duyhoangbk23/CO3091_DA_TKLL_252/Report/sections/05-firmware-doc-du-lieu.tex

\section{Firmware đọc dữ liệu và xử lý cục bộ}

\subsection{Vai trò của firmware}

Firmware chính của hệ thống nằm trong nhánh \texttt{rtos} và chạy trên ESP32 bằng
PlatformIO/Arduino framework kết hợp FreeRTOS. Vai trò của firmware là thu thập dữ liệu
từ các cảm biến, chuẩn hóa thành mẫu đo thống nhất, đánh giá trạng thái chất lượng không
khí và điều khiển cảnh báo cục bộ trước khi dữ liệu được gửi lên backend. Các sketch
kiểm thử phần cứng chỉ phục vụ giai đoạn thử nghiệm từng cảm biến riêng lẻ, không phải
luồng vận hành chính của hệ thống.

Xét theo chức năng, firmware có thể được chia thành ba lớp. Lớp thứ nhất là các driver
giao tiếp với PMS7003, RS485 Modbus và ADC. Lớp thứ hai là \texttt{SensorHub}, có nhiệm
vụ gom dữ liệu từ nhiều nguồn thành một mẫu đo thống nhất. Lớp thứ ba là khối IAQ, gồm
\texttt{IaqEvaluator} và \texttt{IaqController}, chịu trách nhiệm đánh giá trạng thái môi
trường và chuyển kết quả thành trạng thái điều khiển thiết bị mô phỏng, cảnh báo.

\begin{center}
\texttt{Sensor drivers -> SensorHub -> SensorSample -> IaqEvaluator -> IaqController/MQTT}
\end{center}

\subsection{Mô hình dữ liệu trung tâm}

Đơn vị dữ liệu trung tâm của firmware là \texttt{SensorSample}. Cấu trúc này giữ các giá
trị đo dưới dạng phù hợp cho xử lý nhúng, trong đó nhiệt độ, độ ẩm và một số đại lượng
nội bộ được biểu diễn theo fixed-point nhân hệ số 10 để giảm phụ thuộc vào tính toán số
thực ở tầng đọc cảm biến. Đồng thời, mỗi nhóm dữ liệu đều có cờ hợp lệ hoặc giá trị
sentinel đi kèm để phân biệt giữa dữ liệu hợp lệ và dữ liệu thiếu.

\begin{table}[H]
    \centering
    \caption{Các nhóm trường chính của \texttt{SensorSample}}
    \begin{tabularx}{\textwidth}{>{\bfseries}l X}
        \toprule
        Nhóm trường & Vai trò trong firmware \\
        \midrule
        Thời gian đo & Lưu mốc thời gian tương đối tại thời điểm đọc mẫu \\
        PM1.0/PM2.5/PM10 & Giữ dữ liệu bụi mịn từ PMS7003; dùng PM2.5 làm chỉ số chính trong luồng dữ liệu IoT \\
        Nhiệt độ, độ ẩm & Lưu giá trị từ cảm biến RS485 dưới dạng fixed-point x10 \\
        CO\textsubscript{2} & Lưu nồng độ CO\textsubscript{2} theo ppm \\
        VOC & Lưu giá trị VOC raw và giá trị trung bình trượt dùng cho đánh giá \\
        Cờ hợp lệ & Cho biết từng nhóm cảm biến có đọc thành công hay không \\
        \bottomrule
    \end{tabularx}
\end{table}

Cách tổ chức này cho phép tầng đánh giá IAQ làm việc trên một cấu trúc dữ liệu đồng
nhất, thay vì phải phụ thuộc vào chi tiết giao thức của từng cảm biến. Đây cũng là cơ sở
để ánh xạ dữ liệu sang \texttt{SensorData\_t} và telemetry JSON ở các bước sau.

\subsection{Đọc cảm biến và chuẩn hóa dữ liệu}

\texttt{SensorHub} là điểm gom dữ liệu từ ba nhóm giao tiếp phần cứng. Khi được khởi tạo,
thành phần này cấu hình UART1 cho PMS7003, UART2 cho RS485 Modbus và ADC1 cho cảm biến
VOC. Trong quá trình đọc mẫu, từng cảm biến được truy xuất với timeout riêng; nếu một
cảm biến lỗi, mẫu đo vẫn được trả về nhưng nhóm dữ liệu tương ứng được đánh dấu không
hợp lệ.

\begin{table}[H]
    \centering
    \caption{Các driver cảm biến và cách xử lý dữ liệu}
    \begin{tabularx}{\textwidth}{>{\bfseries}l l X}
        \toprule
        Cảm biến & Giao tiếp & Cách xử lý chính \\
        \midrule
        PMS7003 & UART1 9600 bps & Tìm header \texttt{0x42 0x4D}, đọc đủ frame, kiểm tra checksum và tách PM1.0/PM2.5/PM10 \\
        CO\textsubscript{2} RS485 & Modbus RTU & Gửi request function \texttt{0x03}, đọc register \texttt{0x0001}, kiểm tra độ dài response, slave ID, function code và CRC16 \\
        Nhiệt độ/độ ẩm RS485 & Modbus RTU & Gửi request function \texttt{0x03}, đọc hai register từ \texttt{0x0000}, chuyển dữ liệu về dạng fixed-point x10 \\
        VOC analog & ADC1 GPIO34 & Đọc ADC 12-bit, cấu hình attenuation và dùng trung bình trượt để giảm nhiễu tức thời \\
        \bottomrule
    \end{tabularx}
\end{table}

Hai nguyên tắc quan trọng của tầng driver là timeout và kiểm tra giao thức. PMS7003 chỉ
được xem là hợp lệ khi checksum đúng. Với Modbus, response chỉ được chấp nhận khi khớp
slave ID, function code, byte count và CRC16. Nhờ đó, lỗi dây nối, cảm biến chưa cấp
nguồn hoặc nhiễu đường truyền không dẫn đến việc firmware dùng nhầm giá trị rác cho tầng
đánh giá.

\subsection{Đánh giá IAQ và cơ chế hysteresis}

\texttt{IaqEvaluator} là thành phần chuyển \texttt{SensorSample} thành \texttt{IaqState}.
Mỗi đại lượng được so sánh với một cặp ngưỡng bật/tắt để quyết định có cần kích hoạt
thiết bị xử lý hay không. Cơ chế này được triển khai theo hướng hysteresis, nghĩa là hệ
thống không dùng một ngưỡng duy nhất cho cả quá trình bật và tắt thiết bị. Thay vào đó,
thiết bị chỉ được bật khi giá trị đo vượt ngưỡng trên và chỉ tắt khi giá trị quay trở
lại dưới ngưỡng hồi phục.

\begin{table}[H]
    \centering
    \caption{Các ngưỡng điều khiển mặc định trong firmware}
    \begin{tabularx}{\textwidth}{>{\bfseries}l l X}
        \toprule
        Đại lượng & Cặp ngưỡng mặc định & Ý nghĩa vận hành \\
        \midrule
        CO\textsubscript{2} & \texttt{1000/950} ppm & Bật xử lý khi CO\textsubscript{2} cao và chỉ tắt khi đã giảm xuống dưới ngưỡng hồi phục \\
        PM2.5 & \texttt{35/30} \(\mu g/m^3\) & Điều khiển lọc bụi theo mức bụi mịn \\
        VOC & \texttt{500/450} & Điều khiển thông gió và lọc than theo VOC raw/index \\
        Nhiệt độ & \texttt{30.0/28.0} \(^{\circ}C\) & Điều khiển thiết bị làm mát mô phỏng \\
        Độ ẩm thấp & \texttt{30.0/35.0}\%RH & Bật/tắt tạo ẩm \\
        Độ ẩm cao & \texttt{65.0/60.0}\%RH & Bật/tắt thông gió khi quá ẩm \\
        \bottomrule
    \end{tabularx}
\end{table}

Ngoài hysteresis, firmware còn áp dụng thời gian giữ trạng thái mặc định 5000 ms cho các đầu ra xử lý.
Khi trạng thái vừa đổi, thiết bị được giữ tối thiểu trong một khoảng thời gian trước khi
được phép đổi tiếp. Cơ chế này giúp giảm hiện tượng bật/tắt liên tục khi dữ liệu dao
động gần ngưỡng, đặc biệt với các tín hiệu có nhiễu hoặc biến động ngắn hạn.

\subsection{Bảng ánh xạ điều kiện và đầu ra}

Từ góc nhìn vận hành, mỗi nhóm đại lượng môi trường sẽ dẫn đến một tập hành vi điều
khiển tương ứng. Bảng dưới đây tóm tắt quan hệ giữa điều kiện đầu vào và
đầu ra xử lý trong \texttt{IaqState}.

\begin{table}[H]
    \centering
    \caption{Bảng ánh xạ điều kiện môi trường sang trạng thái điều khiển}
    \begin{tabularx}{\textwidth}{>{\bfseries}l X X}
        \toprule
        Thông số & Điều kiện đánh giá & Phản ứng của hệ thống \\
        \midrule
        CO\textsubscript{2} cao & Nồng độ CO\textsubscript{2} vượt ngưỡng cấu hình & Bật \texttt{wantVent}, bật \texttt{wantCarbon}, kích hoạt \texttt{alarmCO2} \\
        PM2.5 cao & PM2.5 vượt ngưỡng bụi mịn & Bật \texttt{wantHepa}, kích hoạt \texttt{alarmPM} \\
        VOC cao & VOC raw/index vượt ngưỡng cấu hình & Bật \texttt{wantVent}, có thể bật \texttt{wantCarbon}, kích hoạt \texttt{alarmVOC} \\
        Nhiệt độ cao & Nhiệt độ vượt ngưỡng trên & Bật \texttt{wantAc}, kích hoạt \texttt{alarmTemp} \\
        Độ ẩm thấp & Độ ẩm dưới ngưỡng thấp & Bật \texttt{wantHumid}, kích hoạt \texttt{alarmRH} khi vượt vùng cảnh báo \\
        Độ ẩm cao & Độ ẩm vượt ngưỡng cao & Bật \texttt{wantVent}, kích hoạt \texttt{alarmRH} khi vượt vùng cảnh báo \\
        Dữ liệu thiếu/lỗi & Cảm biến timeout, mất kết nối hoặc sai giao thức & Giữ cờ trạng thái lỗi, tránh dùng dữ liệu không hợp lệ cho quyết định điều khiển \\
        \bottomrule
    \end{tabularx}
\end{table}

\subsection{Áp dụng điều khiển và lưu dữ liệu}

\texttt{IaqController} không chứa thuật toán đánh giá chất lượng không khí. Thành phần
này chỉ nhận \texttt{IaqState} và ghi trạng thái ra các chân LED mô phỏng thiết bị và
cảnh báo. Nhờ sự tách biệt này, về sau có thể thay LED bằng relay hoặc module công suất
mà không cần thay đổi thuật toán IAQ.

Trong luồng IoT chính, dữ liệu telemetry không được lưu cục bộ dưới dạng CSV trên firmware RTOS.
Thay vào đó, ESP32 gửi dữ liệu bằng MQTT lên topic \texttt{iot/sensor/data}; backend tiếp nhận,
chuẩn hóa giá trị thiếu và lưu vào bảng \texttt{sensor\_data}. Vì vậy, dữ liệu ở MySQL là
nguồn chính để đối chiếu kết quả đo, kiểm tra lịch sử và hiển thị biểu đồ trên
dashboard.
