duyhoangbk23/CO3091_DA_TKLL_252/Report/frontmatter/cover.tex

\begin{titlepage}
\thispagestyle{empty}

\begin{tikzpicture}[remember picture,overlay,inner sep=0,outer sep=0]
     \draw[blue!70!black,line width=4pt] ([xshift=-1.5cm,yshift=-2cm]current page.north east) coordinate (A)--([xshift=1.5cm,yshift=-2cm]current page.north west) coordinate(B)--([xshift=1.5cm,yshift=2cm]current page.south west) coordinate (C)--([xshift=-1.5cm,yshift=2cm]current page.south east) coordinate(D)--cycle;

     \draw ([yshift=0.5cm,xshift=-0.5cm]A)-- ([yshift=0.5cm,xshift=0.5cm]B)--
     ([yshift=-0.5cm,xshift=0.5cm]B) --([yshift=-0.5cm,xshift=-0.5cm]B)--([yshift=0.5cm,xshift=-0.5cm]C)--([yshift=0.5cm,xshift=0.5cm]C)--([yshift=-0.5cm,xshift=0.5cm]C)-- ([yshift=-0.5cm,xshift=-0.5cm]D)--([yshift=0.5cm,xshift=-0.5cm]D)--([yshift=0.5cm,xshift=0.5cm]D)--([yshift=-0.5cm,xshift=0.5cm]A)--([yshift=-0.5cm,xshift=-0.5cm]A)--([yshift=0.5cm,xshift=-0.5cm]A);

     \draw ([yshift=-0.3cm,xshift=0.3cm]A)-- ([yshift=-0.3cm,xshift=-0.3cm]B)--
     ([yshift=0.3cm,xshift=-0.3cm]B) --([yshift=0.3cm,xshift=0.3cm]B)--([yshift=-0.3cm,xshift=0.3cm]C)--([yshift=-0.3cm,xshift=-0.3cm]C)--([yshift=0.3cm,xshift=-0.3cm]C)-- ([yshift=0.3cm,xshift=0.3cm]D)--([yshift=-0.3cm,xshift=0.3cm]D)--([yshift=-0.3cm,xshift=-0.3cm]D)--([yshift=0.3cm,xshift=-0.3cm]A)--([yshift=0.3cm,xshift=0.3cm]A)--([yshift=-0.3cm,xshift=0.3cm]A);
\end{tikzpicture}

\centering
\vspace*{0.2cm}

{\large \textbf{\universityname}\par}
{\large \textbf{\schoolname}\par}
{\large \textbf{\facultyname}\par}

\vspace{0.4cm}
\IfFileExists{\covericonlogo}{
    \par
    \vspace{0.2cm}
}{}

{\Large \textbf{\coursename}\par}
\vspace{0.6cm}
{\Huge \bfseries \reporttitle\par}
\vspace{0.4cm}
{\Large \labtitle\par}
\vspace{0.4cm}
{\normalsize \textcolor{softgray}{\semester}\par}

\vfill

\renewcommand{\arraystretch}{1.25}
\begin{tabularx}{0.84\textwidth}{>{\bfseries}p{5.2cm}X}
\instructorlabel & \instructor \\
\classlabel & \classname \\
\end{tabularx}

\vspace{0.45cm}
\begin{tabular}{|p{8.2cm}|>{\bfseries}p{3cm}|}
\hline
\centering\bfseries \studentlabel & \centering\arraybackslash \studentidlabel \\
\hline
\studenttable
\end{tabular}

\vspace{0.9cm}
{\locationanddate\par}
\vspace*{0.8cm}
\end{titlepage}
