duyhoangbk23/CO3091_DA_TKLL_252/Report/ref/Transaction_Report.docx

SO SÁNH CƠ CHẾ TRANSACTION
GIỮA MYSQL VÀ MONGODB

Bối cảnh minh họa: hệ thống đăng ký học phần và xác nhận học phí.

# Mục tiêu tài liệu

Tài liệu này trình bày transaction trong 2 loại DBMS là MySQL và MongoDB. Nội dung không đi sâu vào cấu trúc nội bộ của storage engine, log hay checkpoint, mà tập trung vào ba câu hỏi chính:

- Mỗi DBMS xem “một thao tác an toàn” là gì?
- Mỗi DBMS giữ dữ liệu đúng bằng cách nào?
- Mỗi DBMS xử lý nhiều transaction cùng lúc ra sao?.

# 1. Transaction là gì?

Transaction là một nhóm thao tác với cơ sở dữ liệu được xem như một đơn vị xử lý duy nhất. Nếu toàn bộ thao tác hợp lệ, hệ thống xác nhận thay đổi. Nếu có lỗi ở bất kỳ bước nào, toàn bộ thay đổi trong nhóm thao tác đó bị hủy.

Ví dụ, khi admin duyệt học phí, hệ thống có thể phải đổi trạng thái các lớp từ “enrolled” sang “payed” và đồng thời bỏ cờ “payment_requested”. Nếu chỉ làm được một nửa, dữ liệu sẽ bị mâu thuẫn. Vì vậy, transaction cần đảm bảo nguyên tắc: hoặc làm trọn vẹn, hoặc không làm gì cả.

# 2. Cơ chế transaction trong MySQL

MySQL làm việc theo mô hình quan hệ. Dữ liệu thường được tách thành nhiều bảng và các bảng liên kết với nhau. Ví dụ, hệ thống đăng ký học phần có thể có bảng sinh viên, môn học, lớp học, đăng ký và trạng thái hệ thống. Vì bản chất dữ liệu có nhiều quan hệ, MySQL xử lý transaction nhiều bảng và nhiều dòng khá tự nhiên.

Trong phạm vi bài này, transaction của MySQL được xét trong trường hợp sử dụng InnoDB. Khi đó, transaction được xử lý chủ yếu ở tầng storage engine: engine chịu trách nhiệm quản lý commit, rollback, khóa dữ liệu, isolation và phục hồi khi có sự cố.

## 2.1. Quy trình xử lý transaction

Ở mức khái niệm, MySQL xử lý transaction theo chuỗi sau:

1. Bắt đầu transaction.
2. Đọc dữ liệu cần kiểm tra hoặc cần cập nhật.
3. Khóa các dòng dữ liệu có nguy cơ bị transaction khác sửa đồng thời.
4. Thực hiện insert, update hoặc delete.
5. Nếu thành công thì xác nhận thay đổi bằng commit.
6. Nếu có lỗi thì hủy toàn bộ thay đổi bằng rollback.

Điểm quan trọng là MySQL không chỉ sửa dữ liệu, mà còn theo dõi trạng thái trước đó để có thể quay lại khi rollback. Vì vậy, nếu một bước trong transaction thất bại, dữ liệu không bị kẹt ở trạng thái nửa cũ nửa mới.

## 2.2. MySQL giữ dữ liệu đúng bằng ràng buộc quan hệ

Trong MySQL, nhiều quy tắc dữ liệu có thể được đặt trực tiếp trong database. Ví dụ: một đăng ký phải thuộc về một sinh viên có thật, một lớp học có thật, và một sinh viên không được đăng ký trùng cùng một lớp. Nếu dữ liệu vi phạm các quy tắc này, MySQL có thể từ chối thao tác ngay cả khi application gửi sai yêu cầu.

Do đó, MySQL đặc biệt phù hợp với các bài toán mà quan hệ giữa dữ liệu rất quan trọng. Trong hệ thống đăng ký học phần, sai quan hệ giữa sinh viên, lớp học và thanh toán có thể làm sai toàn bộ nghiệp vụ, nên cơ chế ràng buộc ở tầng database là một lợi thế lớn.

## 2.3. MySQL xử lý đồng thời như thế nào?

MySQL không bắt mọi transaction chạy lần lượt. Nếu hai transaction thao tác trên dữ liệu khác nhau, chúng có thể chạy song song. Nếu cùng sửa một dòng dữ liệu, một transaction phải chờ transaction còn lại hoàn tất. Khi chỉ đọc dữ liệu, hệ thống có thể cho đọc một phiên bản ổn định thay vì bắt người đọc chờ người ghi.

Tình huống | Cách MySQL xử lý
Hai transaction sửa dữ liệu khác nhau | Có thể chạy song song
Hai transaction cùng sửa một dòng | Một transaction phải chờ
Một transaction sửa, transaction khác đọc | Có thể đọc phiên bản dữ liệu ổn định

# 3. Cơ chế transaction trong MongoDB

MongoDB làm việc theo mô hình document. Một document có thể hiểu gần giống một dòng trong MySQL, nhưng linh hoạt hơn vì có thể chứa nhiều thông tin lồng nhau. Vì vậy, MongoDB thường khuyến khích gom các thông tin thường được dùng hoặc cập nhật cùng nhau vào cùng một document.

Trong MongoDB, multi-document transaction không được triển khai như một cơ chế chỉ nằm riêng ở tầng storage engine. Nó được tổ chức thông qua tầng session/transaction của hệ quản trị, hoạt động trên nền môi trường replica set hoặc sharded cluster, đồng thời phối hợp với storage engine hiện tại để lưu trữ và phục hồi dữ liệu.

## 3.1. MongoDB ưu tiên atomic ở cấp document

Trong MongoDB, một thao tác ghi trên một document đã được đảm bảo atomic. Nếu một thao tác sửa nhiều field bên trong cùng một document, MongoDB sẽ sửa toàn bộ hoặc không sửa gì cả. Vì vậy, nếu dữ liệu được thiết kế sao cho một nghiệp vụ chỉ cần cập nhật một document, MongoDB xử lý rất gọn và không cần transaction nhiều document.

Ví dụ, nếu thông tin đăng ký và trạng thái thanh toán của một sinh viên được gom trong cùng một document, việc cập nhật trạng thái trong document đó là trường hợp MongoDB xử lý rất tự nhiên.

## 3.2. Khi nào MongoDB cần transaction nhiều document?

MongoDB cần transaction nhiều document khi một nghiệp vụ phải đụng đến nhiều document hoặc nhiều collection nhưng vẫn yêu cầu “hoặc thành công toàn bộ, hoặc hủy toàn bộ”. Ví dụ, trong đăng ký học phần, nếu dữ liệu được tách ra thành collection system_state, classes và enrollments, một nghiệp vụ đăng ký có thể phải đọc trạng thái hệ thống, đọc lớp học, kiểm tra xung đột lịch và thêm đăng ký mới.

Khi đó, MongoDB dùng session transaction để gom các thao tác lại. Nếu mọi thao tác thành công thì commit; nếu có lỗi thì abort. Cách này vẫn đảm bảo được transaction, nhưng đòi hỏi nhiều quản lý ở tầng ứng dụng hơn so với MySQL.

## 3.3. Vì sao replica set xuất hiện trong MongoDB transaction?

Replica set là mô hình MongoDB chạy với node chính và các node phụ sao chép dữ liệu. Vai trò quan trọng hơn của replica set là cung cấp môi trường cần thiết cho transaction nhiều document: xác nhận commit, sao chép dữ liệu, chịu lỗi và tiếp tục hoạt động khi node chính gặp sự cố.

Nếu thiếu replica set, MongoDB standalone vẫn có thể CRUD bình thường và vẫn atomic trên một document. Tuy nhiên, khi cần transaction nhiều document hoặc nhiều collection, standalone không phải là môi trường phù hợp.

MongoDB standalone | MongoDB replica set
Phù hợp cho CRUD và atomic một document | Phù hợp cho CRUD, atomic một document và transaction nhiều document
Không có tự động thay node chính khi lỗi | Có khả năng chịu lỗi và bầu node chính mới
Không phải lựa chọn phù hợp cho multi-document transaction | Là môi trường cần thiết cho multi-document transaction

# 4. So sánh transaction của MySQL và MongoDB trên lý thuyết

Trọng tâm của phần so sánh này là cách mỗi DBMS giải quyết bài toán transaction và kiểu bài toán mà cách giải quyết đó phù hợp.

## 4.1. Điểm giống nhau

MySQL và MongoDB đều hỗ trợ tư tưởng transaction để bảo vệ dữ liệu khỏi trạng thái cập nhật dang dở. Cả hai đều có cơ chế xác nhận thay đổi khi thành công và hủy thay đổi khi thất bại. Cả hai cũng cần kiểm soát việc đọc/ghi đồng thời để transaction này không làm hỏng dữ liệu của transaction khác.

- Đều hướng tới nguyên tắc all-or-nothing.
- Đều có cơ chế xác nhận thay đổi khi transaction thành công.
- Đều có cơ chế hủy thay đổi khi transaction thất bại.
- Đều phải xử lý vấn đề nhiều transaction đọc/ghi cùng lúc.

## 4.2. Điểm khác nhau cốt lõi

### Khác biệt 1: Phạm vi atomicity mặc định

Trong MySQL/InnoDB, atomicity mặc định được hiểu theo câu lệnh SQL khi autocommit được bật. Nghĩa là mỗi câu lệnh INSERT, UPDATE hoặc DELETE được xem như một transaction nhỏ: hoặc toàn bộ câu lệnh thành công, hoặc toàn bộ câu lệnh bị hủy. Một câu lệnh SQL có thể tác động đến một dòng hoặc nhiều dòng trong bảng. Khi cần gom nhiều câu lệnh lại với nhau, MySQL cho phép mở transaction rõ ràng bằng START TRANSACTION, lúc đó atomicity được đảm bảo cho toàn bộ nhóm thao tác cho đến khi COMMIT hoặc ROLLBACK.

Trong MongoDB, atomicity mặc định được đảm bảo ở cấp một document. Một thao tác ghi có thể cập nhật nhiều field, object lồng nhau hoặc mảng bên trong cùng một document, và MongoDB đảm bảo thao tác đó hoặc thành công toàn bộ, hoặc thất bại toàn bộ. Tuy nhiên, nếu nghiệp vụ cần cập nhật nhiều document hoặc nhiều collection, MongoDB phải dùng multi-document transaction.

### Khác biệt 2: Cách giữ dữ liệu đúng

Trong MySQL, tính nhất quán của transaction được hỗ trợ mạnh bởi các ràng buộc ở tầng database như khóa ngoại, khóa duy nhất, kiểu dữ liệu và điều kiện hợp lệ. Vì vậy, nếu một transaction cố gắng thêm dữ liệu sai, ví dụ đăng ký vào một lớp không tồn tại hoặc đăng ký trùng lớp, MySQL có thể tự phát hiện và từ chối.

Trong MongoDB, database không kiểm soát quan hệ giữa các collection chặt như MySQL. Khi một transaction liên quan đến nhiều collection, việc kiểm tra dữ liệu có hợp lệ hay không thường phải được viết rõ trong logic xử lý, ví dụ phải tự kiểm tra lớp có tồn tại, sinh viên có đăng ký trùng hay không, hoặc trạng thái có hợp lệ hay không.

## 4.3. Bảng tóm tắt

Tiêu chí | MySQL | MongoDB
Cách tổ chức dữ liệu | Bảng, dòng, quan hệ giữa bảng | Collection, document, dữ liệu linh hoạt
Atomicity mặc định | Câu lệnh | Một document
Giữ dữ liệu đúng | Ràng buộc ở tầng database | Thiết kế document, index, validation, logic ứng dụng
Kiểu bài toán phù hợp | Nhiều quan hệ chặt, nghiệp vụ cần nhất quán cao | Dữ liệu linh hoạt, có thể gom theo document, cần mở rộng tốt

# 5. Nhận xét sơ bộ trước khi xây dựng kịch bản demo

Với hệ thống đăng ký học phần và xác nhận học phí, MySQL thường là lựa chọn tự nhiên hơn cho phần transaction vì nghiệp vụ có nhiều quan hệ dữ liệu: sinh viên, lớp học, môn học, đăng ký và thanh toán. Các thao tác như đăng ký lớp, kiểm tra trùng lịch, yêu cầu thanh toán hoặc duyệt thanh toán đều dễ trở thành transaction nhiều bảng.

MongoDB vẫn có thể thực hiện các transaction tương tự, nhưng sẽ phù hợp hơn nếu thiết kế dữ liệu theo hướng document và giảm số nghiệp vụ phải trải rộng qua nhiều collection. Khi phải dùng multi-document transaction thường xuyên, MongoDB cần thêm session transaction và môi trường triển khai phù hợp, nên cách triển khai có thể phức tạp hơn.

Kết luận ngắn gọn: MySQL giải quyết transaction theo hướng quan hệ và nhất quán dữ liệu chặt; MongoDB giải quyết transaction theo hướng document-first, ưu tiên atomicity trong một document và mở rộng sang multi-document transaction khi thật sự cần.

# 6. Ghi chú thuật ngữ tối giản

Thuật ngữ | Cách hiểu ngắn gọn
Transaction | Một nhóm thao tác: thành công toàn bộ hoặc hủy toàn bộ
Commit | Xác nhận thay đổi là chính thức
Rollback / Abort | Hủy thay đổi trong transaction
Document | Đơn vị dữ liệu chính trong MongoDB
Replica set | Môi trường MongoDB nhiều node, cần cho transaction nhiều document

# 7. Tài liệu tham khảo

- MySQL 8.0 Reference Manual - InnoDB and transactions: https://dev.mysql.com/doc/refman/8.0/en/innodb-storage-engine.html
- MySQL 8.0 Reference Manual - START TRANSACTION, COMMIT, ROLLBACK: https://dev.mysql.com/doc/refman/8.0/en/commit.html
- MongoDB Manual - Transactions: https://www.mongodb.com/docs/manual/core/transactions/
- MongoDB Manual - Atomicity and Transactions: https://www.mongodb.com/docs/manual/core/write-operations-atomicity/
- Tài liệu nội bộ đã cung cấp: Transaction-demonstrations.md.
