duyhoangbk23/CO3091_DA_TKLL_252/Report/ref/indexing-lab/mongo_result.txt

========== DATASET SIZE ==========
{
  products: 20000,
  users: 5000,
  orders: 50000,
  stores: 1000
}

========== 1. DEFAULT INDEX: _id INDEX ==========

--- Find product by _id ---
{
  nReturned: 1,
  totalKeysExamined: 1,
  totalDocsExamined: 1,
  executionTimeMillis: 0,
  winningPlan: {
    stage: 'IDHACK'
  }
}

========== 2A. FIELD INDEX - BEFORE creating index on sku, likely COLLSCAN ==========

--- Find product by sku without index ---
{
  nReturned: 1,
  totalKeysExamined: 0,
  totalDocsExamined: 20000,
  executionTimeMillis: 6,
  winningPlan: {
    stage: 'COLLSCAN',
    filter: {
      sku: {
        '$eq': 'SKU000123'
      }
    },
    direction: 'forward'
  }
}

========== 2B. FIELD INDEX - AFTER creating index on sku ==========

--- Find product by sku with field index ---
{
  nReturned: 1,
  totalKeysExamined: 1,
  totalDocsExamined: 1,
  executionTimeMillis: 0,
  winningPlan: {
    stage: 'FETCH',
    inputStage: {
      stage: 'IXSCAN',
      keyPattern: {
        sku: 1
      },
      indexName: 'idx_products_sku',
      isMultiKey: false,
      multiKeyPaths: {
        sku: []
      },
      isUnique: false,
      isSparse: false,
      isPartial: false,
      indexVersion: 2,
      direction: 'forward',
      indexBounds: {
        sku: [
          '["SKU000123", "SKU000123"]'
        ]
      }
    }
  }
}

========== 3A. COMPOUND INDEX {categoryId: 1, price: 1} - query matches leftmost prefix ==========

--- Filter by categoryId and price range, then sort by price ---
{
  nReturned: 541,
  totalKeysExamined: 541,
  totalDocsExamined: 541,
  executionTimeMillis: 1,
  winningPlan: {
    stage: 'FETCH',
    inputStage: {
      stage: 'IXSCAN',
      keyPattern: {
        categoryId: 1,
        price: 1
      },
      indexName: 'idx_products_category_price',
      isMultiKey: false,
      multiKeyPaths: {
        categoryId: [],
        price: []
      },
      isUnique: false,
      isSparse: false,
      isPartial: false,
      indexVersion: 2,
      direction: 'forward',
      indexBounds: {
        categoryId: [
          '[3, 3]'
        ],
        price: [
          '[100000, 500000]'
        ]
      }
    }
  }
}

========== 3B. COMPOUND INDEX {categoryId: 1, price: 1} - query only on price, less optimal ==========

--- Filter only by price, price is not the leftmost field ---
{
  nReturned: 10811,
  totalKeysExamined: 0,
  totalDocsExamined: 20000,
  executionTimeMillis: 11,
  winningPlan: {
    stage: 'SORT',
    sortPattern: {
      price: 1
    },
    memLimit: 104857600,
    type: 'simple',
    inputStage: {
      stage: 'COLLSCAN',
      filter: {
        '$and': [
          {
            price: {
              '$lte': 500000
            }
          },
          {
            price: {
              '$gte': 100000
            }
          }
        ]
      },
      direction: 'forward'
    }
  }
}

========== 4. COVERED QUERY - filter and projection are inside the same index; _id is excluded ==========

--- Covered query on sku/name projection ---
{
  nReturned: 1,
  totalKeysExamined: 1,
  totalDocsExamined: 0,
  executionTimeMillis: 0,
  winningPlan: {
    stage: 'PROJECTION_COVERED',
    transformBy: {
      _id: 0,
      sku: 1,
      name: 1
    },
    inputStage: {
      stage: 'IXSCAN',
      keyPattern: {
        sku: 1,
        name: 1
      },
      indexName: 'idx_products_sku_name',
      isMultiKey: false,
      multiKeyPaths: {
        sku: [],
        name: []
      },
      isUnique: false,
      isSparse: false,
      isPartial: false,
      indexVersion: 2,
      direction: 'forward',
      indexBounds: {
        sku: [
          '["SKU000123", "SKU000123"]'
        ],
        name: [
          '[MinKey, MaxKey]'
        ]
      }
    }
  }
}

========== 5A. PARTIAL INDEX - ACTIVE orders are indexed ==========

--- ACTIVE orders by userId should be able to use partial index ---
{
  nReturned: 10,
  totalKeysExamined: 10,
  totalDocsExamined: 10,
  executionTimeMillis: 0,
  winningPlan: {
    stage: 'FETCH',
    inputStage: {
      stage: 'IXSCAN',
      keyPattern: {
        userId: 1,
        orderDate: -1
      },
      indexName: 'idx_active_orders_user_date',
      isMultiKey: false,
      multiKeyPaths: {
        userId: [],
        orderDate: []
      },
      isUnique: false,
      isSparse: false,
      isPartial: true,
      indexVersion: 2,
      direction: 'forward',
      indexBounds: {
        userId: [
          '[123, 123]'
        ],
        orderDate: [
          '[MaxKey, MinKey]'
        ]
      }
    }
  }
}

========== 5B. PARTIAL INDEX - CLOSED orders are outside the partial index ==========

--- CLOSED orders by userId should not use the ACTIVE partial index ---
{
  nReturned: 0,
  totalKeysExamined: 0,
  totalDocsExamined: 50000,
  executionTimeMillis: 13,
  winningPlan: {
    stage: 'SORT',
    sortPattern: {
      orderDate: -1
    },
    memLimit: 104857600,
    type: 'simple',
    inputStage: {
      stage: 'COLLSCAN',
      filter: {
        '$and': [
          {
            status: {
              '$eq': 'CLOSED'
            }
          },
          {
            userId: {
              '$eq': 123
            }
          }
        ]
      },
      direction: 'forward'
    }
  }
}

========== 6. MULTIKEY INDEX - array field tags ==========

--- Find products by tag before multikey index ---
{
  nReturned: 6666,
  totalKeysExamined: 0,
  totalDocsExamined: 20000,
  executionTimeMillis: 6,
  winningPlan: {
    stage: 'COLLSCAN',
    filter: {
      tags: {
        '$eq': 'organic'
      }
    },
    direction: 'forward'
  }
}

--- Find products by tag after multikey index ---
{
  nReturned: 6666,
  totalKeysExamined: 6666,
  totalDocsExamined: 6666,
  executionTimeMillis: 5,
  winningPlan: {
    stage: 'FETCH',
    inputStage: {
      stage: 'IXSCAN',
      keyPattern: {
        tags: 1
      },
      indexName: 'idx_products_tags',
      isMultiKey: true,
      multiKeyPaths: {
        tags: [
          'tags'
        ]
      },
      isUnique: false,
      isSparse: false,
      isPartial: false,
      indexVersion: 2,
      direction: 'forward',
      indexBounds: {
        tags: [
          '["organic", "organic"]'
        ]
      }
    }
  }
}

========== 7. RELATIONAL-LIKE QUERY WITH $lookup - supported, but not usually the main MongoDB design style ==========

--- User by email + lookup orders ---
{
  explainVersion: '1',
  stages: [
    {
      '$cursor': {
        queryPlanner: {
          namespace: 'indexing_lab.users',
          indexFilterSet: false,
          parsedQuery: {
            email: {
              '$eq': 'user123@example.com'
            }
          },
          queryHash: 'DF585FA6',
          planCacheKey: '0DA6E0DB',
          optimizationTimeMillis: 0,
          maxIndexedOrSolutionsReached: false,
          maxIndexedAndSolutionsReached: false,
          maxScansToExplodeReached: false,
          winningPlan: {
            stage: 'PROJECTION_SIMPLE',
            transformBy: {
              _id: 1,
              email: 1
            },
            inputStage: {
              stage: 'FETCH',
              inputStage: {
                stage: 'IXSCAN',
                keyPattern: {
                  email: 1
                },
                indexName: 'idx_users_email',
                isMultiKey: false,
                multiKeyPaths: {
                  email: []
                },
                isUnique: false,
                isSparse: false,
                isPartial: false,
                indexVersion: 2,
                direction: 'forward',
                indexBounds: {
                  email: [
                    '["user123@example.com", "user123@example.com"]'
                  ]
                }
              }
            }
          },
          rejectedPlans: []
        },
        executionStats: {
          executionSuccess: true,
          nReturned: 1,
          executionTimeMillis: 1,
          totalKeysExamined: 1,
          totalDocsExamined: 1,
          executionStages: {
            stage: 'PROJECTION_SIMPLE',
            nReturned: 1,
            executionTimeMillisEstimate: 0,
            works: 2,
            advanced: 1,
            needTime: 0,
            needYield: 0,
            saveState: 1,
            restoreState: 1,
            isEOF: 1,
            transformBy: {
              _id: 1,
              email: 1
            },
            inputStage: {
              stage: 'FETCH',
              nReturned: 1,
              executionTimeMillisEstimate: 0,
              works: 2,
              advanced: 1,
              needTime: 0,
              needYield: 0,
              saveState: 1,
              restoreState: 1,
              isEOF: 1,
              docsExamined: 1,
              alreadyHasObj: 0,
              inputStage: {
                stage: 'IXSCAN',
                nReturned: 1,
                executionTimeMillisEstimate: 0,
                works: 2,
                advanced: 1,
                needTime: 0,
                needYield: 0,
                saveState: 1,
                restoreState: 1,
                isEOF: 1,
                keyPattern: {
                  email: 1
                },
                indexName: 'idx_users_email',
                isMultiKey: false,
                multiKeyPaths: {
                  email: []
                },
                isUnique: false,
                isSparse: false,
                isPartial: false,
                indexVersion: 2,
                direction: 'forward',
                indexBounds: {
                  email: [
                    '["user123@example.com", "user123@example.com"]'
                  ]
                },
                keysExamined: 1,
                seeks: 1,
                dupsTested: 0,
                dupsDropped: 0
              }
            }
          }
        }
      },
      nReturned: Long('1'),
      executionTimeMillisEstimate: Long('0')
    },
    {
      '$lookup': {
        from: 'orders',
        as: 'orders',
        localField: '_id',
        foreignField: 'userId'
      },
      totalDocsExamined: Long('10'),
      totalKeysExamined: Long('10'),
      collectionScans: Long('0'),
      indexesUsed: [
        'idx_orders_user_id'
      ],
      nReturned: Long('1'),
      executionTimeMillisEstimate: Long('1')
    },
    {
      '$project': {
        _id: true,
        email: true,
        orderCount: {
          '$size': [
            '$orders'
          ]
        }
      },
      nReturned: Long('1'),
      executionTimeMillisEstimate: Long('1')
    }
  ],
  serverInfo: {
    host: 'b87a4a2cfe65',
    port: 27017,
    version: '7.0.32',
    gitVersion: '40a2e0f542b0a68f0ed51fa216e9d38b9917fe14'
  },
  serverParameters: {
    internalQueryFacetBufferSizeBytes: 104857600,
    internalQueryFacetMaxOutputDocSizeBytes: 104857600,
    internalLookupStageIntermediateDocumentMaxSizeBytes: 104857600,
    internalDocumentSourceGroupMaxMemoryBytes: 104857600,
    internalQueryMaxBlockingSortMemoryUsageBytes: 104857600,
    internalQueryProhibitBlockingMergeOnMongoS: 0,
    internalQueryMaxAddToSetBytes: 104857600,
    internalDocumentSourceSetWindowFieldsMaxMemoryBytes: 104857600,
    internalQueryFrameworkControl: 'forceClassicEngine'
  },
  command: {
    aggregate: 'users',
    pipeline: [
      {
        '$match': {
          email: 'user123@example.com'
        }
      },
      {
        '$lookup': {
          from: 'orders',
          localField: '_id',
          foreignField: 'userId',
          as: 'orders'
        }
      },
      {
        '$project': {
          email: 1,
          orderCount: {
            '$size': '$orders'
          }
        }
      }
    ],
    cursor: {},
    '$db': 'indexing_lab'
  },
  ok: 1
}

========== 8. SPECIALIZED INDEX - text index ==========

--- Text search on products ---
{
  nReturned: 20000,
  totalKeysExamined: 40000,
  totalDocsExamined: 20000,
  executionTimeMillis: 65,
  winningPlan: {
    stage: 'PROJECTION_DEFAULT',
    transformBy: {
      score: {
        '$meta': 'textScore'
      },
      name: 1
    },
    inputStage: {
      stage: 'SORT',
      sortPattern: {
        '$computed0': {
          '$meta': 'textScore'
        }
      },
      memLimit: 104857600,
      type: 'default',
      inputStage: {
        stage: 'TEXT_MATCH',
        indexPrefix: {},
        indexName: 'idx_products_text',
        parsedTextQuery: {
          terms: [
            'organ',
            'wireless'
          ],
          negatedTerms: [],
          phrases: [],
          negatedPhrases: []
        },
        textIndexVersion: 3,
        inputStage: {
          stage: 'TEXT_OR',
          inputStages: [
            {
              stage: 'IXSCAN',
              keyPattern: {
                _fts: 'text',
                _ftsx: 1
              },
              indexName: 'idx_products_text',
              isMultiKey: true,
              isUnique: false,
              isSparse: false,
              isPartial: false,
              indexVersion: 2,
              direction: 'backward',
              indexBounds: {}
            },
            {
              stage: 'IXSCAN',
              keyPattern: {
                _fts: 'text',
                _ftsx: 1
              },
              indexName: 'idx_products_text',
              isMultiKey: true,
              isUnique: false,
              isSparse: false,
              isPartial: false,
              indexVersion: 2,
              direction: 'backward',
              indexBounds: {}
            }
          ]
        }
      }
    }
  }
}

========== 9. SPECIALIZED INDEX - 2dsphere geospatial index ==========

--- Find stores near a point ---
{
  nReturned: 400,
  totalKeysExamined: 480,
  totalDocsExamined: 470,
  executionTimeMillis: 1,
  winningPlan: {
    stage: 'GEO_NEAR_2DSPHERE',
    keyPattern: {
      location: '2dsphere'
    },
    indexName: 'idx_stores_location',
    indexVersion: 2,
    inputStages: [
      {
        stage: 'FETCH',
        inputStage: {
          stage: 'IXSCAN',
          keyPattern: {
            location: '2dsphere'
          },
          indexName: 'idx_stores_location',
          isMultiKey: false,
          multiKeyPaths: {
            location: []
          },
          isUnique: false,
          isSparse: false,
          isPartial: false,
          indexVersion: 2,
          direction: 'forward',
          indexBounds: {
            location: [
              '[3530822107858468864, 3530822107858468864]',
              '[3548836506367950848, 3548836506367950848]',
              '[3562347305250062336, 3562347305250062336]',
              '[3563473205156904960, 3563473205156904960]',
              '[3563754680133615616, 3563754680133615616]',
              '[3563794262552215552, 3563794262552215552]',
              '[3563795362063843328, 3563795362063843328]',
              '[3563795950474362880, 3563795950474362880]',
              '[3563795953695588352, 3563795953695588352]',
              '[3563795954232459265, 3563795954769330175]',
              '[3563795954769330177, 3563795963359264767]',
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
              '[3563796564654686209, 3563796573244620799]',
              '[3563796573244620801, 3563796581834555391]',
              '[3563796581834555392, 3563796581834555392]',
              '[3563796581834555393, 3563796583982039039]',
              '[3563796583982039041, 3563796586129522687]',
              '[3563796586129522688, 3563796586129522688]',
              '[3563796588277006337, 3563796590424489983]',
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
            ]
          }
        }
      }
    ]
  }
}

========== 10. WRITE COST - compare insert into collection with few indexes vs many indexes ==========
{
  write_light_ms: 31,
  write_heavy_ms: 58
}

========== DONE - MongoDB indexing tests finished ==========
