duyhoangbk23/CO3091_DA_TKLL_252/Report/ref/indexing-lab/mysql_result.txt

section
DATASET SIZE
products	users	orders	product_tags	stores
20000	5000	50000	20341	1000
section
1. DEFAULT INDEX: PRIMARY KEY / CLUSTERED INDEX IN INNODB
EXPLAIN
-> Rows fetched before execution  (cost=0..0 rows=1) (actual time=356e-6..385e-6 rows=1 loops=1)\n
section
2A. SECONDARY INDEX - BEFORE creating index on sku, likely table scan
EXPLAIN
-> Filter: (products.sku = 'SKU000123')  (cost=2265 rows=1977) (actual time=0.0482..6.45 rows=1 loops=1)\n    -> Table scan on products  (cost=2265 rows=19772) (actual time=0.00638..5.13 rows=20000 loops=1)\n
section
2B. SECONDARY INDEX - AFTER creating index on sku
EXPLAIN
-> Index lookup on products using idx_products_sku (sku='SKU000123')  (cost=1.1 rows=1) (actual time=0.00927..0.01 rows=1 loops=1)\n
section
3A. COMPOSITE INDEX (category_id, price) - query matches leftmost prefix
EXPLAIN
-> Index range scan on products using idx_products_category_price over (category_id = 3 AND 100000 <= price <= 500000), with index condition: ((products.category_id = 3) and (products.price between 100000 and 500000))  (cost=649 rows=541) (actual time=0.0662..0.569 rows=541 loops=1)\n
section
3B. COMPOSITE INDEX (category_id, price) - query only on price, less optimal because price is not leftmost
EXPLAIN
-> Sort: products.price  (cost=2265 rows=19772) (actual time=4.65..5.02 rows=10811 loops=1)\n    -> Filter: (products.price between 100000 and 500000)  (cost=2265 rows=19772) (actual time=0.371..3.13 rows=10811 loops=1)\n        -> Table scan on products  (cost=2265 rows=19772) (actual time=0.0245..2.35 rows=20000 loops=1)\n
section
4. COVERING INDEX - SELECT and WHERE columns are inside the same index
EXPLAIN
-> Covering index lookup on products using idx_products_sku_name (sku='SKU000123')  (cost=1.08 rows=1) (actual time=0.00652..0.00729 rows=1 loops=1)\n
section
5A. MYSQL PARTIAL-INDEX EMULATION - typical query may NOT use expression index directly
EXPLAIN
-> Filter: ((orders.user_id = 123) and (orders.`status` = 'ACTIVE'))  (cost=5065 rows=501) (actual time=0.11..7.42 rows=10 loops=1)\n    -> Table scan on orders  (cost=5065 rows=50086) (actual time=0.0959..5.63 rows=50000 loops=1)\n
section
5B. MYSQL PARTIAL-INDEX EMULATION - expression query can use the functional index
EXPLAIN
-> Filter: ((case when (orders.`status` = 'ACTIVE') then orders.user_id else NULL end) = 123)  (cost=5065 rows=50086) (actual time=0.126..9.65 rows=10 loops=1)\n    -> Table scan on orders  (cost=5065 rows=50086) (actual time=0.108..5.82 rows=50000 loops=1)\n
section
6A. JOIN QUERY - BEFORE supporting indexes on users.email and orders.user_id
EXPLAIN
-> Nested loop inner join  (cost=22595 rows=5009) (actual time=0.209..48.6 rows=10 loops=1)\n    -> Table scan on o  (cost=5065 rows=50086) (actual time=0.082..7.27 rows=50000 loops=1)\n    -> Filter: (u.email = 'user123@example.com')  (cost=0.25 rows=0.1) (actual time=761e-6..762e-6 rows=200e-6 loops=50000)\n        -> Single-row index lookup on u using PRIMARY (user_id=o.user_id)  (cost=0.25 rows=1) (actual time=598e-6..617e-6 rows=1 loops=50000)\n
section
6B. JOIN QUERY - AFTER supporting indexes on users.email and orders.user_id
EXPLAIN
-> Nested loop inner join  (cost=4.5 rows=9.93) (actual time=0.0577..0.0608 rows=10 loops=1)\n    -> Covering index lookup on u using idx_users_email (email='user123@example.com')  (cost=1.03 rows=1) (actual time=0.00578..0.00649 rows=1 loops=1)\n    -> Index lookup on o using idx_orders_user_id (user_id=u.user_id)  (cost=3.47 rows=9.93) (actual time=0.0507..0.0524 rows=10 loops=1)\n
section
7. ARRAY-LIKE DATA IN MYSQL - normalized product_tags table needs index on tag
EXPLAIN
-> Limit: 20 row(s)  (cost=8301 rows=20) (actual time=0.0701..0.0881 rows=20 loops=1)\n    -> Nested loop inner join  (cost=8301 rows=6666) (actual time=0.0692..0.0864 rows=20 loops=1)\n        -> Covering index lookup on pt using idx_product_tags_tag_product (tag='organic')  (cost=989 rows=6666) (actual time=0.0633..0.0653 rows=20 loops=1)\n        -> Single-row index lookup on p using PRIMARY (product_id=pt.product_id)  (cost=0.997 rows=1) (actual time=887e-6..906e-6 rows=1 loops=20)\n
section
8. SPECIALIZED INDEX - FULLTEXT search
EXPLAIN
-> Limit: 20 row(s)  (cost=1.1 rows=1) (actual time=2.56..2.58 rows=20 loops=1)\n    -> Filter: (match products.`name`,products.`description` against ('wireless organic'))  (cost=1.1 rows=1) (actual time=2.56..2.58 rows=20 loops=1)\n        -> Full-text index search on products using idx_products_text (name='wireless organic')  (cost=1.1 rows=1) (actual time=2.55..2.57 rows=20 loops=1)\n
section
9. SPECIALIZED INDEX - SPATIAL index with bounding box
EXPLAIN
-> Limit: 20 row(s)  (cost=0.71 rows=1) (actual time=0.14..0.225 rows=20 loops=1)\n    -> Filter: mbrcontains(<cache>(st_geomfromtext('POLYGON((10.70 106.60, 10.70 106.85, 10.90 106.85, 10.90 106.60, 10.70 106.60))',4326)),stores.location)  (cost=0.71 rows=1) (actual time=0.14..0.223 rows=20 loops=1)\n        -> Index range scan on stores using idx_stores_location over (location unprintable_geometry_value)  (cost=0.71 rows=1) (actual time=0.0834..0.103 rows=20 loops=1)\n
section
10. WRITE COST - compare insert into table with few indexes vs many indexes
write_light_ms
62.4140
write_heavy_ms
132.5350
section
DONE - MySQL indexing tests finished
