duyhoangbk23/CO3091_DA_TKLL_252/Report/assets/Schematic_ESP32-Air-Monitoring-RS485-System_2026-05-16.pdf

## POWER SUPPLY

## MCU-ESP32

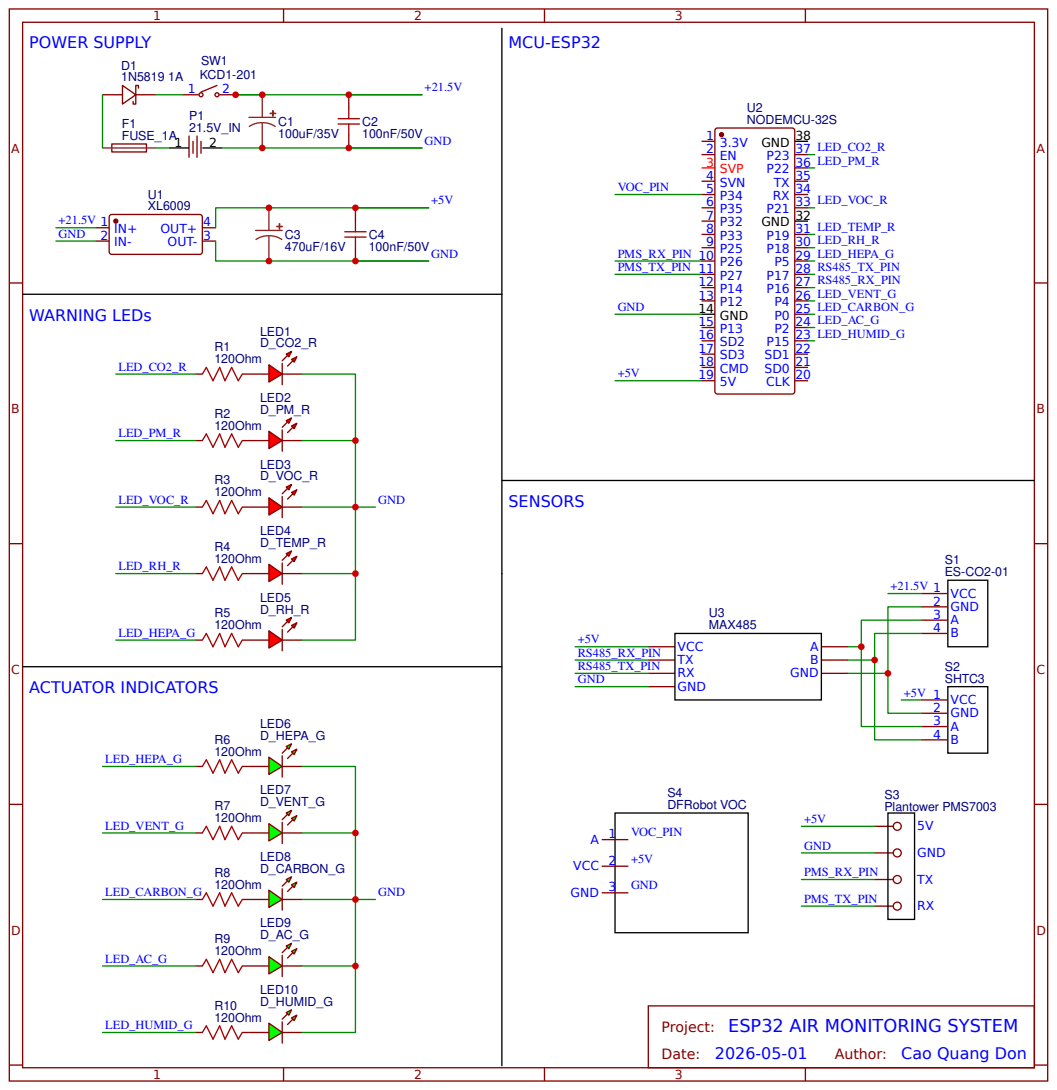
[picture p3: page 1]

Project: ESP32 AIR MONITORING SYSTEM
