duyhoangbk23/CO3091_DA_TKLL_252/IOT_RTOS_Project/rtos/include/local_config.example.h

#ifndef LOCAL_CONFIG_H
#define LOCAL_CONFIG_H

#define DEVICE_ID "esp32_device"

#define WIFI_SSID "Z Robotics"
#define WIFI_PASSWORD "28102023"

#define MQTT_BROKER_HOST "192.168.110.148"
#define MQTT_BROKER_PORT 1883

// Optional credentials if your broker requires authentication.
// #define MQTT_USERNAME "YOUR_MQTT_USERNAME"
// #define MQTT_PASSWORD "YOUR_MQTT_PASSWORD"

#endif
