duyhoangbk23/CO3091_DA_TKLL_252/(commit log)

2026-04-21 Mô tả nội dung bạn đã thay đổi
2026-05-10 Add Docker infra and IoT backend scaffold
    Add containerized infrastructure and initial Node.js backend scaffolding for the IoT project. Changes include docker-compose, Dockerfile, mosquitto.conf and nginx.conf, updated .gitignore, and documentation (DOCKER_SETUP.md, DAY1_COMPLETION.md). Backend additions: env example, ESLint and Jest configs, package.json scripts and dependencies, logger (winston), DB connection module, controllers (sensor & control), middleware (validation & error handler), services, models, routes, test setup, and server adjustments to support MQTT, MySQL, and realtime features. This provides a baseline for local development, testing, and Day 2 refactoring.
2026-05-11 Add air_quality & alert_level, unify timestamp
    Introduce air_quality and alert_level sensor fields across the stack and standardize timestamp as an integer (epoch ms). Updates include: backend controller and model changes to store the new fields and save timestamp as bigint; expanded DB schema/README with new columns and an index on timestamp; MQTT client/service mapping now parses air_quality, alert_level and timestamp and allows topic configuration via env vars; RTOS protocol/docs and MQTT task payload renamed fields to match backend (temperature/humidity/air_quality/alert_level/timestamp); remove test_pc.exe binary. Also adjust queries (latest-by-device ordering by timestamp) and logging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
2026-05-11 Add air_quality/alert_level and timestamp_ms
    Standardize telemetry contract and propagate new sensor fields across the stack. Adds common artifacts (data_format.json, mqtt_topics.h, updated README/sample docs) that define device_id, air_quality, alert_level and timestamp_ms as the canonical fields and MQTT topics. Backend changes: validation, controller, model, MQTT client and service, DB queries and save logic updated to store timestamp_ms (aliasing DB timestamp column), and tests updated to cover the new payload. Frontend: dashboard and analytics updated to show air quality, alert level and device timestamp; API client now surfaces received_at. RTOS docs and config.h updated to include DEV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
2026-05-11 Add ESP32 firmware + test for sensors
2026-05-12 Update RTOS logic, add mock data test and fix alert levels
    [Pins.h, config.h, data_process.cpp, global.cpp, main.cpp]
